medhyal/ecp5-dev-board/README.md

# ecp5-dev-board
ECP5 FPGA DEV BOARD

Lattice LFE5U-12F FPGA  
Built in FTDI FT2232H Programmer

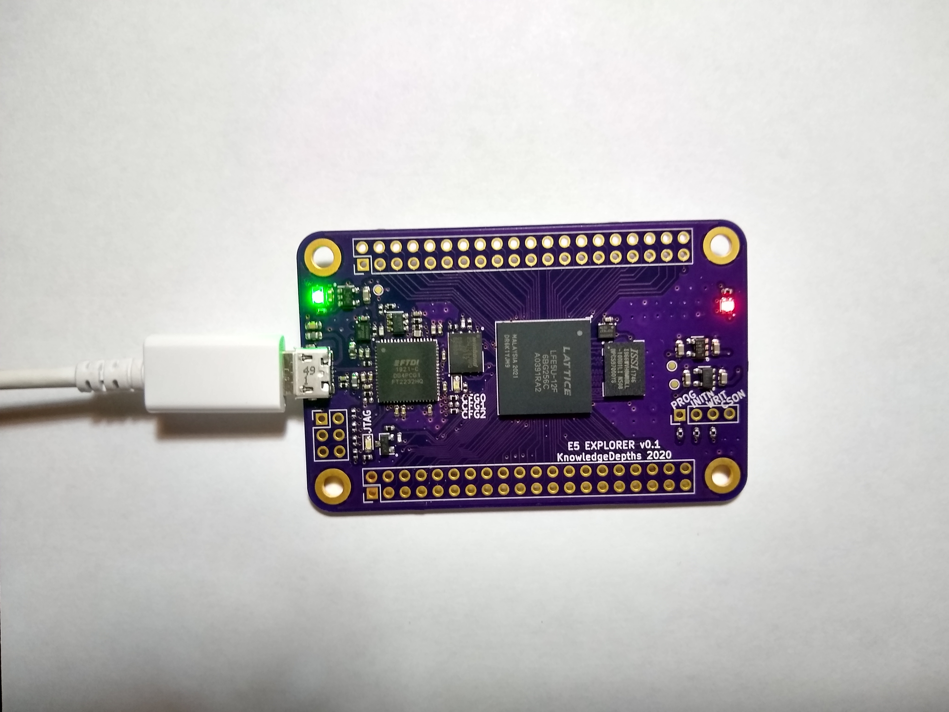
[picture p1: media/ecp5-dev-board.jpg]
ECP5-DEV-BOARD


Errata:  
Q1 - wrong footprint
