medhyal/ecp5-dev-board/v0.1/ecp5-dev-board.kicad_pcb

## KiCad design v0.1/ecp5-dev-board.kicad_pcb (2021-04-18)

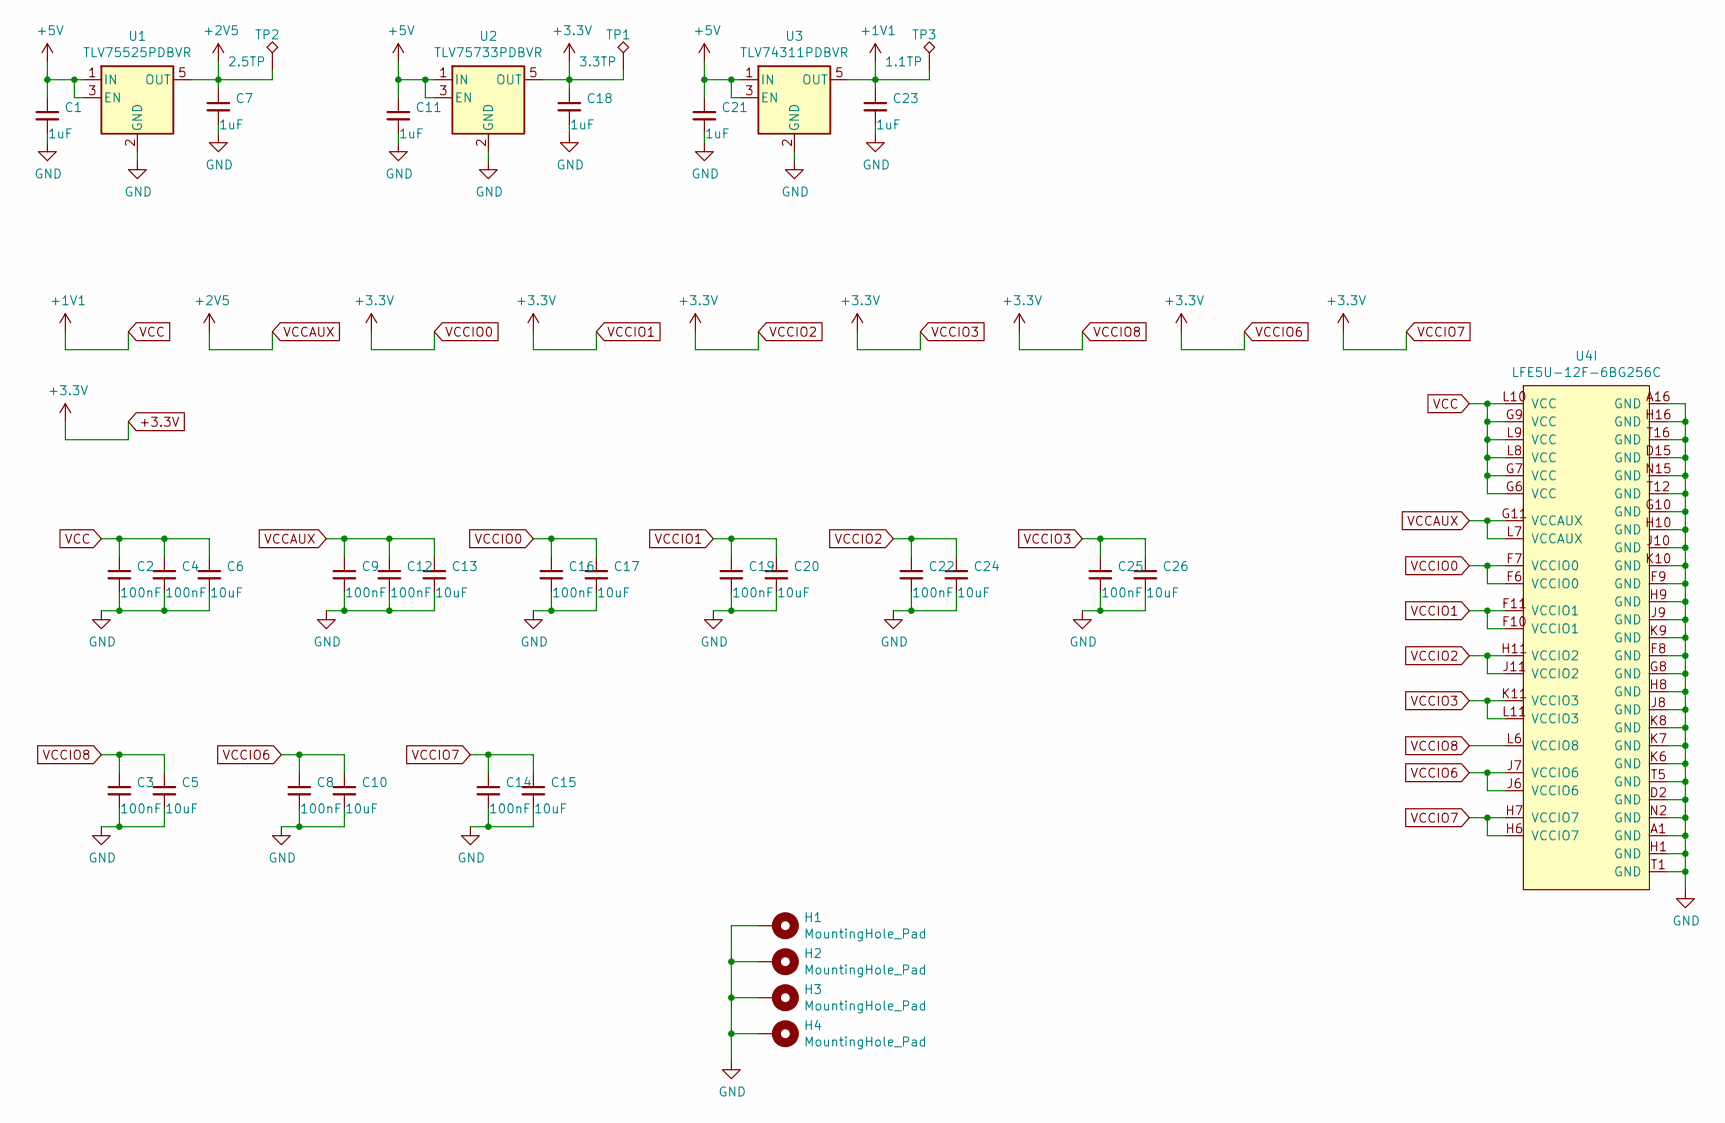
[picture p2: schematic POWER.sch, ECP5 DEV BOARD]

Parts:
C1, C7, C11, C18, C21, C23: 1uF; C_0603_1608Metric
C2, C3, C4, C8, C9, C12, C14, C16, C19, C22, C25: 100nF; C_0402_1005Metric
C5, C6, C10, C13, C15, C17, C20, C24, C26: 10uF; C_0402_1005Metric
H1, H2, H3, H4: MountingHole_Pad; MountingHole_3.2mm_M3_ISO14580_Pad
TP1: 3.3TP; TestPoint_Pad_D1.0mm
TP2: 2.5TP; TestPoint_Pad_D1.0mm
TP3: 1.1TP; TestPoint_Pad_D1.0mm
U1: TLV75525PDBVR; SOT-23-5
U2: TLV75733PDBVR; SOT-23-5
U3: TLV74311PDBVR; SOT-23-5
U4: LFE5U-12F-6BG256C; BGA-256_14.0x14.0mm_Layout16x16_P0.8mm_Ball0.45mm_Pad0.32mm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

Connections:
+3.3V: C3.1, C5.1, C8.1, C10.1, C14.1, C15.1, C16.1, C17.1, C18.1, C19.1, C20.1, C22.1, C24.1, C25.1, C26.1, TP1.1, U2.5 (OUT), U4.F6 (VCCIO0), U4.F7 (VCCIO0), U4.F10 (VCCIO1), U4.F11 (VCCIO1), U4.H6 (VCCIO7), U4.H7 (VCCIO7), U4.H11 (VCCIO2), U4.J6 (VCCIO6), U4.J7 (VCCIO6), U4.J11 (VCCIO2), U4.K11 (VCCIO3), U4.L6 (VCCIO8), U4.L11 (VCCIO3); also elsewhere on the board
+5V: C1.1, C11.1, C21.1, U1.1 (IN), U1.3 (EN), U2.1 (IN), U2.3 (EN), U3.1 (IN), U3.3 (EN); also elsewhere on the board
VCC: C2.1, C4.1, C6.1, C23.1, TP3.1, U3.5 (OUT), U4.G6 (VCC), U4.G7 (VCC), U4.G9 (VCC), U4.L8 (VCC), U4.L9 (VCC), U4.L10 (VCC)
VCCAUX: C7.1, C9.1, C12.1, C13.1, TP2.1, U1.5 (OUT), U4.G11 (VCCAUX), U4.L7 (VCCAUX)

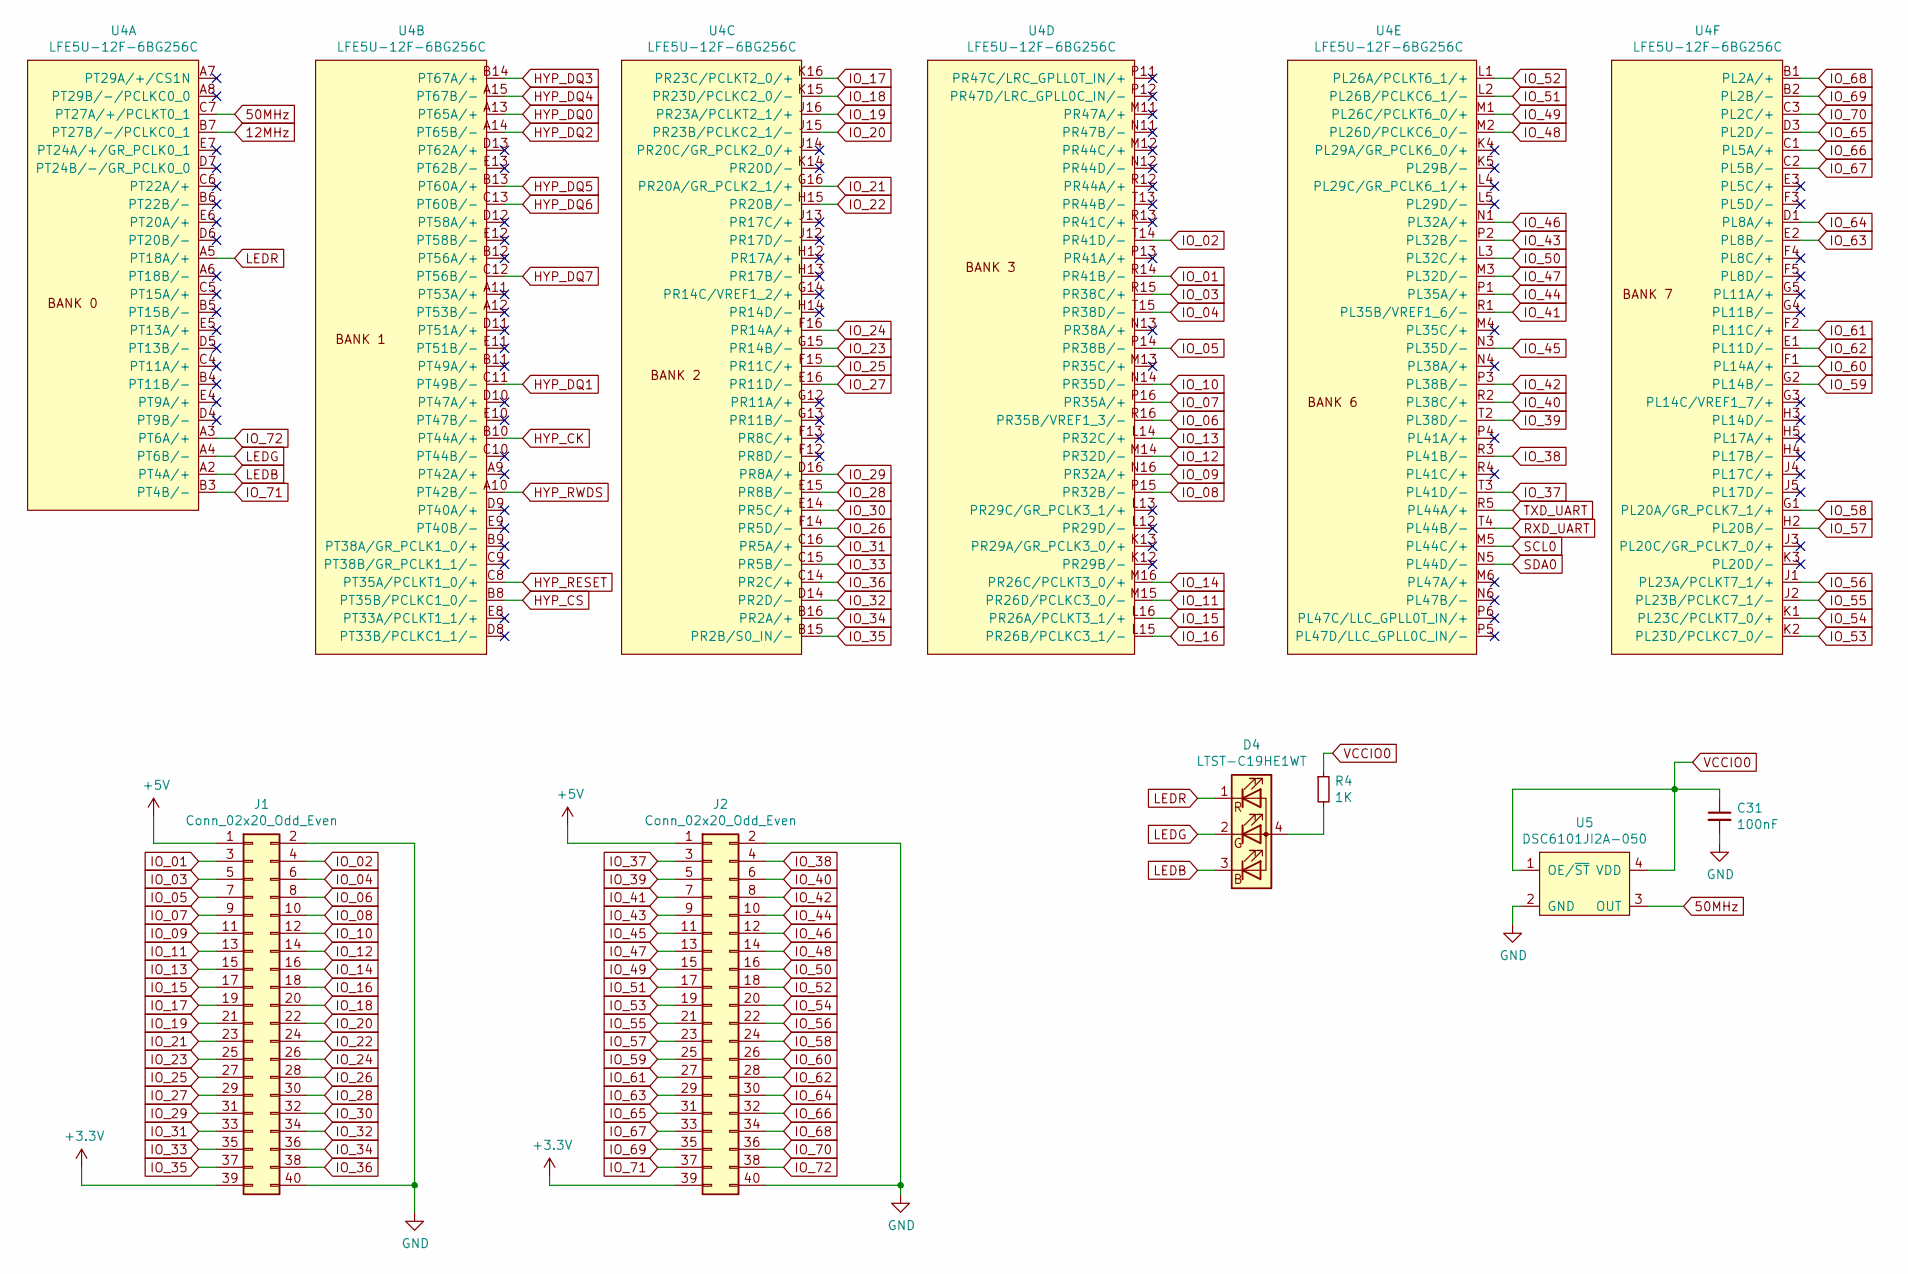
[picture p3: schematic FPGA.sch, ECP5 DEV BOARD]

Parts:
C31: 100nF; C_0402_1005Metric
D4: ‎LTST-C19HE1WT‎; LED_LiteOn_LTST-C19HE1WT
J1, J2: Conn_02x20_Odd_Even; PinHeader_2x20_P2.54mm_Vertical
R4: 1K; R_0402_1005Metric
U4: LFE5U-12F-6BG256C; BGA-256_14.0x14.0mm_Layout16x16_P0.8mm_Ball0.45mm_Pad0.32mm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
U5: DSC6101JI2A-050; DSC6101JI2A-012

Connections:
12MHz: U4.B7 (PT27B/-/PCLKC0_1); also elsewhere on the board
50MHz: U4.C7 (PT27A/+/PCLKT0_1), U5.3 (OUT)
+3.3V: C31.1, J1.39, J2.39, R4.1, U5.1 (OE/~ST), U5.4 (VDD); also elsewhere on the board
+5V: J1.1, J2.1; also elsewhere on the board
HYP_CK: U4.B10 (PT44A/+); also elsewhere on the board
HYP_CS: U4.B8 (PT35B/PCLKC1_0/-); also elsewhere on the board
HYP_DQ0: U4.A13 (PT65A/+); also elsewhere on the board
HYP_DQ1: U4.C11 (PT49B/-); also elsewhere on the board
HYP_DQ2: U4.A14 (PT65B/-); also elsewhere on the board
HYP_DQ3: U4.B14 (PT67A/+); also elsewhere on the board
HYP_DQ4: U4.A15 (PT67B/-); also elsewhere on the board
HYP_DQ5: U4.B13 (PT60A/+); also elsewhere on the board
HYP_DQ6: U4.C13 (PT60B/-); also elsewhere on the board
HYP_DQ7: U4.C12 (PT56B/-); also elsewhere on the board
HYP_RESET: U4.C8 (PT35A/PCLKT1_0/+); also elsewhere on the board
HYP_RWDS: U4.A10 (PT42B/-); also elsewhere on the board
IO_01: J1.3, U4.R14 (PR41B/-)
IO_02: J1.4, U4.T14 (PR41D/-)
IO_03: J1.5, U4.R15 (PR38C/+)
IO_04: J1.6, U4.T15 (PR38D/-)
IO_05: J1.7, U4.P14 (PR38B/-)
IO_06: J1.8, U4.R16 (PR35B/VREF1_3/-)
IO_07: J1.9, U4.P16 (PR35A/+)
IO_08: J1.10, U4.P15 (PR32B/-)
IO_09: J1.11, U4.N16 (PR32A/+)
IO_10: J1.12, U4.N14 (PR35D/-)
IO_11: J1.13, U4.M15 (PR26D/PCLKC3_0/-)
IO_12: J1.14, U4.M14 (PR32D/-)
IO_13: J1.15, U4.L14 (PR32C/+)
IO_14: J1.16, U4.M16 (PR26C/PCLKT3_0/+)
IO_15: J1.17, U4.L16 (PR26A/PCLKT3_1/+)
IO_16: J1.18, U4.L15 (PR26B/PCLKC3_1/-)
IO_17: J1.19, U4.K16 (PR23C/PCLKT2_0/+)
IO_18: J1.20, U4.K15 (PR23D/PCLKC2_0/-)
IO_19: J1.21, U4.J16 (PR23A/PCLKT2_1/+)
IO_20: J1.22, U4.J15 (PR23B/PCLKC2_1/-)
IO_21: J1.23, U4.G16 (PR20A/GR_PCLK2_1/+)
IO_22: J1.24, U4.H15 (PR20B/-)
IO_23: J1.25, U4.G15 (PR14B/-)
IO_24: J1.26, U4.F16 (PR14A/+)
IO_25: J1.27, U4.F15 (PR11C/+)
IO_26: J1.28, U4.F14 (PR5D/-)
IO_27: J1.29, U4.E16 (PR11D/-)
IO_28: J1.30, U4.E15 (PR8B/-)
IO_29: J1.31, U4.D16 (PR8A/+)
IO_30: J1.32, U4.E14 (PR5C/+)
IO_31: J1.33, U4.C16 (PR5A/+)
IO_32: J1.34, U4.D14 (PR2D/-)
IO_33: J1.35, U4.C15 (PR5B/-)
IO_34: J1.36, U4.B16 (PR2A/+)
IO_35: J1.37, U4.B15 (PR2B/S0_IN/-)
IO_36: J1.38, U4.C14 (PR2C/+)
IO_37: J2.3, U4.T3 (PL41D/-)
IO_38: J2.4, U4.R3 (PL41B/-)
IO_39: J2.5, U4.T2 (PL38D/-)
IO_40: J2.6, U4.R2 (PL38C/+)
IO_41: J2.7, U4.R1 (PL35B/VREF1_6/-)
IO_42: J2.8, U4.P3 (PL38B/-)
IO_43: J2.9, U4.P2 (PL32B/-)
IO_44: J2.10, U4.P1 (PL35A/+)
IO_45: J2.11, U4.N3 (PL35D/-)
IO_46: J2.12, U4.N1 (PL32A/+)
IO_47: J2.13, U4.M3 (PL32D/-)
IO_48: J2.14, U4.M2 (PL26D/PCLKC6_0/-)
IO_49: J2.15, U4.M1 (PL26C/PCLKT6_0/+)
IO_50: J2.16, U4.L3 (PL32C/+)
IO_51: J2.17, U4.L2 (PL26B/PCLKC6_1/-)
IO_52: J2.18, U4.L1 (PL26A/PCLKT6_1/+)
IO_53: J2.19, U4.K2 (PL23D/PCLKC7_0/-)
IO_54: J2.20, U4.K1 (PL23C/PCLKT7_0/+)
IO_55: J2.21, U4.J2 (PL23B/PCLKC7_1/-)
IO_56: J2.22, U4.J1 (PL23A/PCLKT7_1/+)
IO_57: J2.23, U4.H2 (PL20B/-)
IO_58: J2.24, U4.G1 (PL20A/GR_PCLK7_1/+)
IO_59: J2.25, U4.G2 (PL14B/-)
IO_60: J2.26, U4.F1 (PL14A/+)
IO_61: J2.27, U4.F2 (PL11C/+)
IO_62: J2.28, U4.E1 (PL11D/-)
IO_63: J2.29, U4.E2 (PL8B/-)
IO_64: J2.30, U4.D1 (PL8A/+)
IO_65: J2.31, U4.D3 (PL2D/-)
IO_66: J2.32, U4.C1 (PL5A/+)
IO_67: J2.33, U4.C2 (PL5B/-)
IO_68: J2.34, U4.B1 (PL2A/+)
IO_69: J2.35, U4.B2 (PL2B/-)
IO_70: J2.36, U4.C3 (PL2C/+)
IO_71: J2.37, U4.B3 (PT4B/-)
IO_72: J2.38, U4.A3 (PT6A/+)
LEDB: D4.3 (BK), U4.A2 (PT4A/+)
LEDG: D4.2 (GK), U4.A4 (PT6B/-)
LEDR: D4.1 (RK), U4.A5 (PT18A/+)
unnamed: D4.4 (A), R4.2
RXD_UART: U4.N5 (PL44D/-), U4.T4 (PL44B/-); also elsewhere on the board
SCL0: U4.M5 (PL44C/+), U4.R5 (PL44A/+); also elsewhere on the board

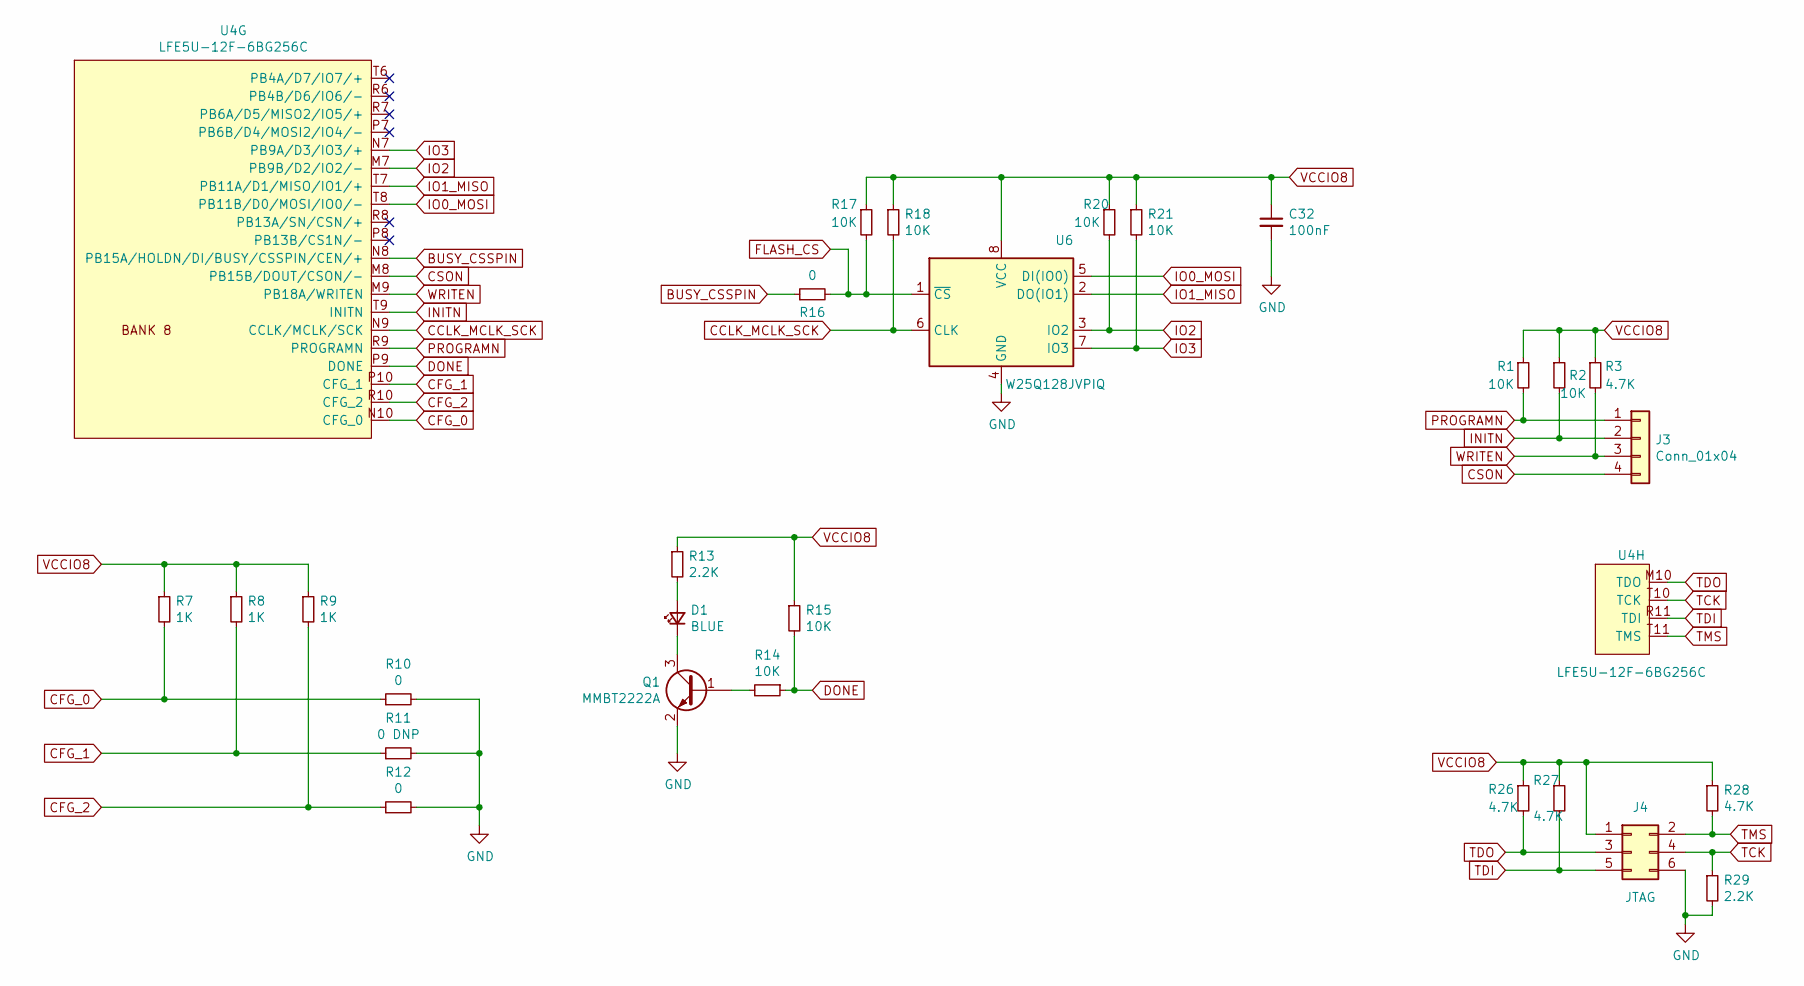
[picture p4: schematic CONFIG.sch, ECP5 DEV BOARD]

Parts:
C32: 100nF; C_0402_1005Metric
D1: BLUE; LED_0603_1608Metric
J3: Conn_01x04; PinHeader_1x04_P2.54mm_Vertical
J4: JTAG; PinHeader_2x03_P2.54mm_Vertical
Q1: MMBT2222A; SOT-23
R1, R2, R14, R15, R17, R18, R20, R21: 10K; R_0402_1005Metric
R3, R26, R27, R28: 4.7K; R_0402_1005Metric
R7, R8, R9: 1K; R_0402_1005Metric
R10, R12, R16: 0; R_0402_1005Metric
R11: 0 DNP; R_0402_1005Metric
R13, R29: 2.2K; R_0402_1005Metric
U4: LFE5U-12F-6BG256C; BGA-256_14.0x14.0mm_Layout16x16_P0.8mm_Ball0.45mm_Pad0.32mm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
U6: W25Q128JVPIQ; WSON-8-1EP_6x5mm_P1.27mm_EP3.4x4.3mm

Connections:
+3.3V: C32.1, J4.1, R1.1, R2.1, R3.1, R7.1, R8.1, R9.1, R13.1, R15.1, R17.1, R18.1, R20.1, R21.1, R26.1, R27.1, R28.1, U6.8 (VCC); also elsewhere on the board
BUSY_CSSPIN: R16.1, U4.N8 (PB15A/HOLDN/DI/BUSY/CSSPIN/CEN/+)
CCLK_MCLK_SCK: R18.2, U4.N9 (CCLK/MCLK/SCK), U6.6 (CLK)
CFG_0: R7.2, R10.1, U4.N10 (CFG_0)
CFG_1: R8.2, R11.1, U4.P10 (CFG_1)
CFG_2: R9.2, R12.1, U4.R10 (CFG_2)
CSON: J3.4, U4.M8 (PB15B/DOUT/CSON/-)
DONE: R14.1, R15.2, U4.P9 (DONE)
FLASH_CS: R16.2, R17.2, U6.1 (~CS)
INITN: J3.2, R2.2, U4.T9 (INITN)
IO0_MOSI: U4.T8 (PB11B/D0/MOSI/IO0/-), U6.5 (DI(IO0))
IO1_MISO: U4.T7 (PB11A/D1/MISO/IO1/+), U6.2 (DO(IO1))
IO2: R20.2, U4.M7 (PB9B/D2/IO2/-), U6.3 (IO2)
IO3: R21.2, U4.N7 (PB9A/D3/IO3/+), U6.7 (IO3)
unnamed: D1.1 (K), Q1.3 (C)
unnamed: D1.2 (A), R13.2
PROGRAMN: J3.1, R1.2, U4.R9 (PROGRAMN)
TCK: J4.4, R29.1, U4.T10 (TCK); also elsewhere on the board
TDI: J4.5, R27.2, U4.R11 (TDI); also elsewhere on the board
TDO: J4.3, R26.2, U4.M10 (TDO); also elsewhere on the board
TMS: J4.2, R28.2, U4.T11 (TMS); also elsewhere on the board
WRITEN: J3.3, R3.2, U4.M9 (PB18A/WRITEN)

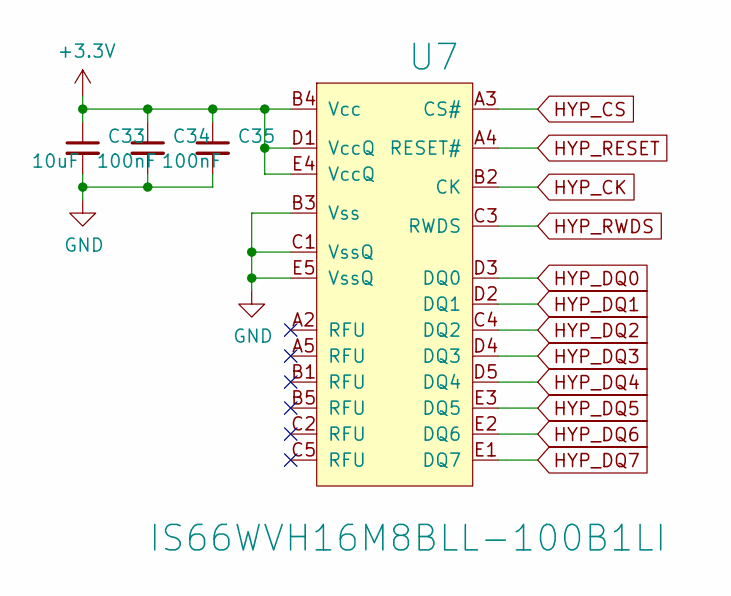
[picture p5: schematic RAM.sch, ECP5 DEV BOARD]

Parts:
C33: 10uF; C_0402_1005Metric
C34, C35: 100nF; C_0402_1005Metric
U7: IS66WVH16M8BLL-100B1LI; 24-TFBGA (6x8)

Connections:
+3.3V: C33.1, C34.1, C35.1, U7.B4 (Vcc), U7.D1 (VccQ), U7.E4 (VccQ); also elsewhere on the board
HYP_CK: U7.B2 (CK); also elsewhere on the board
HYP_CS: U7.A3 (CS#); also elsewhere on the board
HYP_DQ0: U7.D3 (DQ0); also elsewhere on the board
HYP_DQ1: U7.D2 (DQ1); also elsewhere on the board
HYP_DQ2: U7.C4 (DQ2); also elsewhere on the board
HYP_DQ3: U7.D4 (DQ3); also elsewhere on the board
HYP_DQ4: U7.D5 (DQ4); also elsewhere on the board
HYP_DQ5: U7.E3 (DQ5); also elsewhere on the board
HYP_DQ6: U7.E2 (DQ6); also elsewhere on the board
HYP_DQ7: U7.E1 (DQ7); also elsewhere on the board
HYP_RESET: U7.A4 (RESET#); also elsewhere on the board
HYP_RWDS: U7.C3 (RWDS); also elsewhere on the board

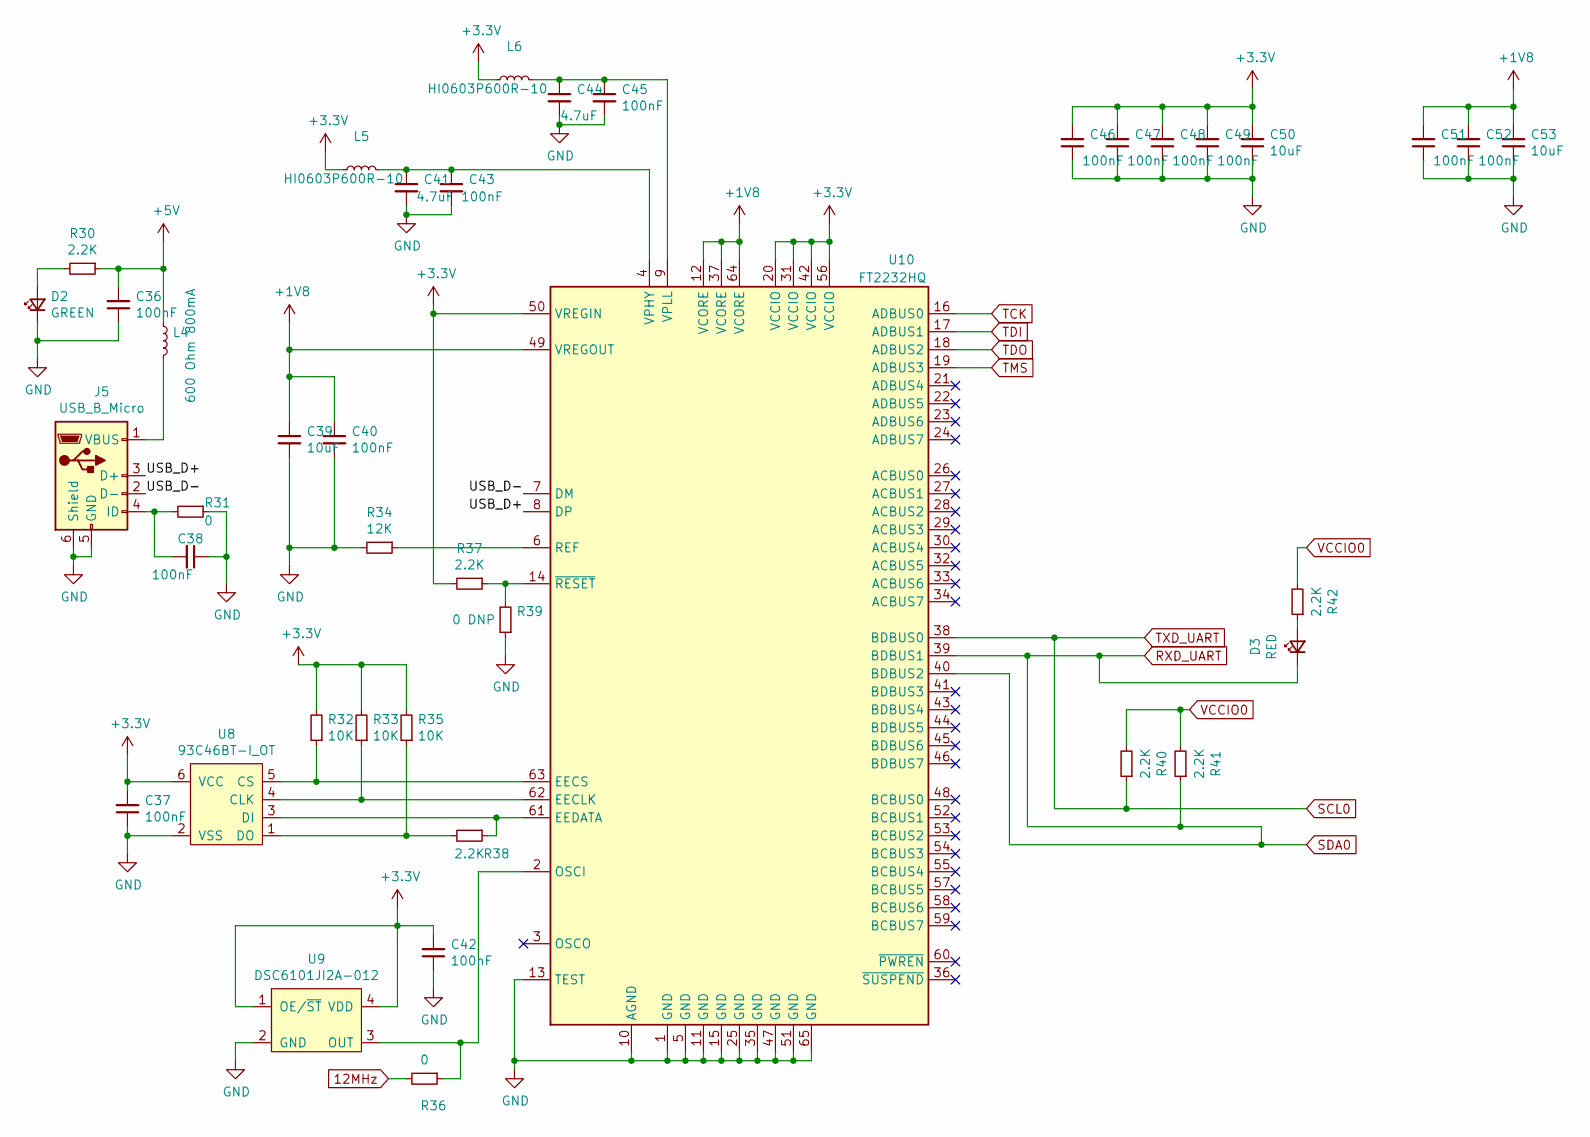
[picture p6: schematic USB_FTDI.sch, ECP5 DEV BOARD]

Parts:
C36: 100nF; C_0603_1608Metric
C37, C38, C40, C42, C43, C45, C46, C47, C48, C49, C51, C52: 100nF; C_0402_1005Metric
C39, C50, C53: 10uF; C_0402_1005Metric
C41, C44: 4.7uF; C_0402_1005Metric
D2: GREEN; LED_0603_1608Metric
D3: RED; LED_0603_1608Metric
J5: USB_B_Micro; USB_Micro-B_Molex_47346-0001
L4: 600 Ohm 800mA; L_0603_1608Metric
L5, L6: HI0603P600R-10; L_0603_1608Metric
R30, R37, R38, R40, R41, R42: 2.2K; R_0402_1005Metric
R31, R36: 0; R_0402_1005Metric
R32, R33, R35: 10K; R_0402_1005Metric
R34: 12K; R_0402_1005Metric
R39: 0 DNP; R_0402_1005Metric
U8: 93C46BT-I_OT; SOT-23-6
U9: DSC6101JI2A-012
U10: FT2232HQ; QFN-64-1EP_9x9mm_P0.5mm_EP4.35x4.35mm

Connections:
12MHz: R36.2; also elsewhere on the board
+1V8: C39.1, C40.1, C51.2, C52.2, C53.2, U10.12 (VCORE), U10.37 (VCORE), U10.49 (VREGOUT), U10.64 (VCORE)
+3.3V: C37.2, C42.2, C46.2, C47.2, C48.2, C49.2, C50.2, L5.1, L6.1, R32.2, R33.2, R35.2, R37.2, R40.2, R41.2, R42.2, U8.6 (VCC), U9.1 (OE/~ST), U9.4 (VDD), U10.20 (VCCIO), U10.31 (VCCIO), U10.42 (VCCIO), U10.50 (VREGIN), U10.56 (VCCIO); also elsewhere on the board
+5V: C36.2, L4.1, R30.1; also elsewhere on the board
/USB_FTDI/USB_D+: J5.3 (D+), U10.8 (DP)
/USB_FTDI/USB_D-: J5.2 (D-), U10.7 (DM)
unnamed: C38.2, J5.4 (ID), R31.2
unnamed: C41.1, C43.1, L5.2, U10.4 (VPHY)
unnamed: C44.1, C45.1, L6.2, U10.9 (VPLL)
unnamed: D2.2 (A), R30.2
unnamed: D3.2 (A), R42.1
unnamed: J5.1 (VBUS), L4.2
unnamed: R32.1, U8.5 (CS), U10.63 (EECS)
unnamed: R33.1, U8.4 (CLK), U10.62 (EECLK)
unnamed: R34.1, U10.6 (REF)
unnamed: R35.1, R38.2, U8.1 (DO)
unnamed: R36.1, U9.3 (OUT), U10.2 (OSCI)
unnamed: R37.1, R39.2, U10.14 (~RESET)
unnamed: R38.1, U8.3 (DI), U10.61 (EEDATA)
RXD_UART: D3.1 (K), R41.1, U10.39 (BDBUS1), U10.40 (BDBUS2); also elsewhere on the board
SCL0: R40.1, U10.38 (BDBUS0); also elsewhere on the board
TCK: U10.16 (ADBUS0); also elsewhere on the board
TDI: U10.17 (ADBUS1); also elsewhere on the board
TDO: U10.18 (ADBUS2); also elsewhere on the board
TMS: U10.19 (ADBUS3); also elsewhere on the board

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
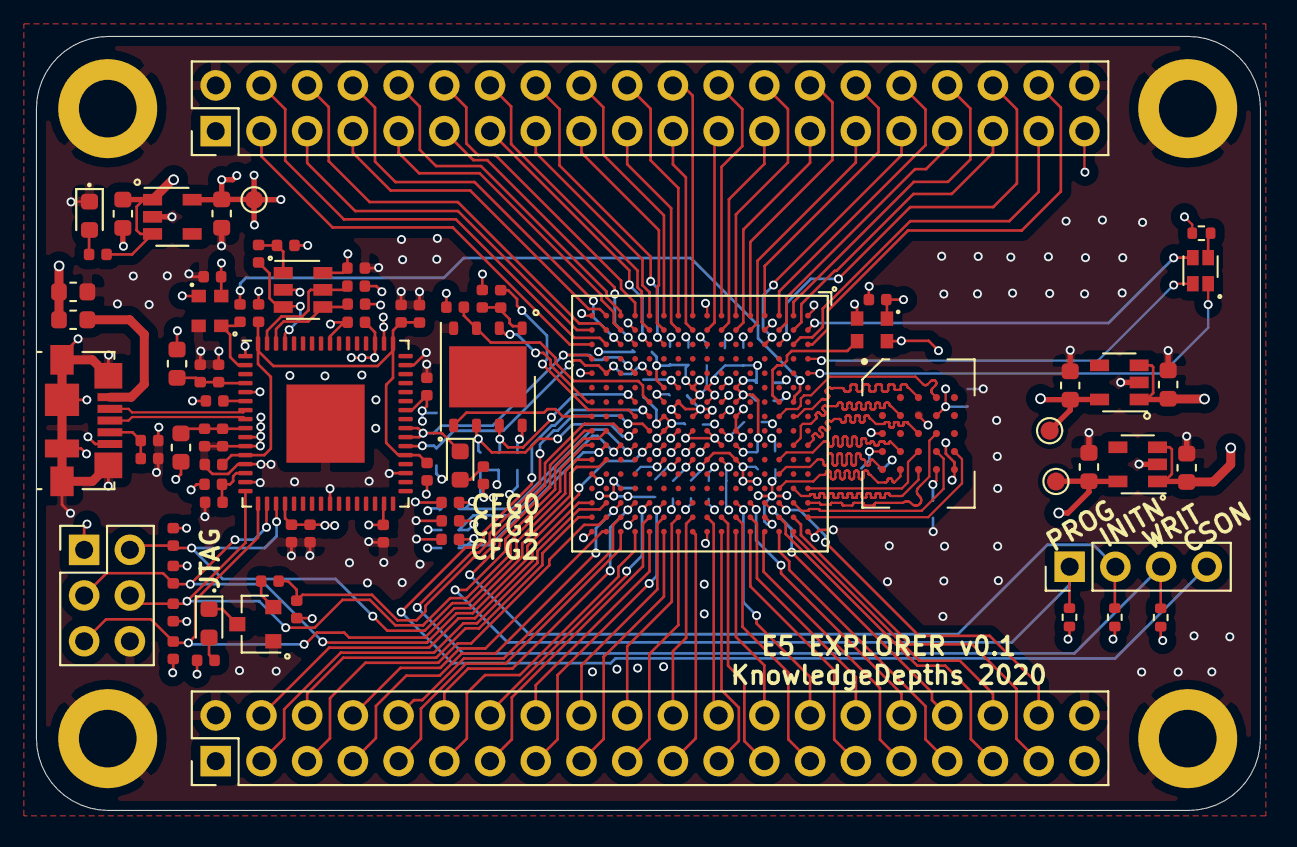
[picture p7: board ecp5-dev-board.kicad_pcb from above]

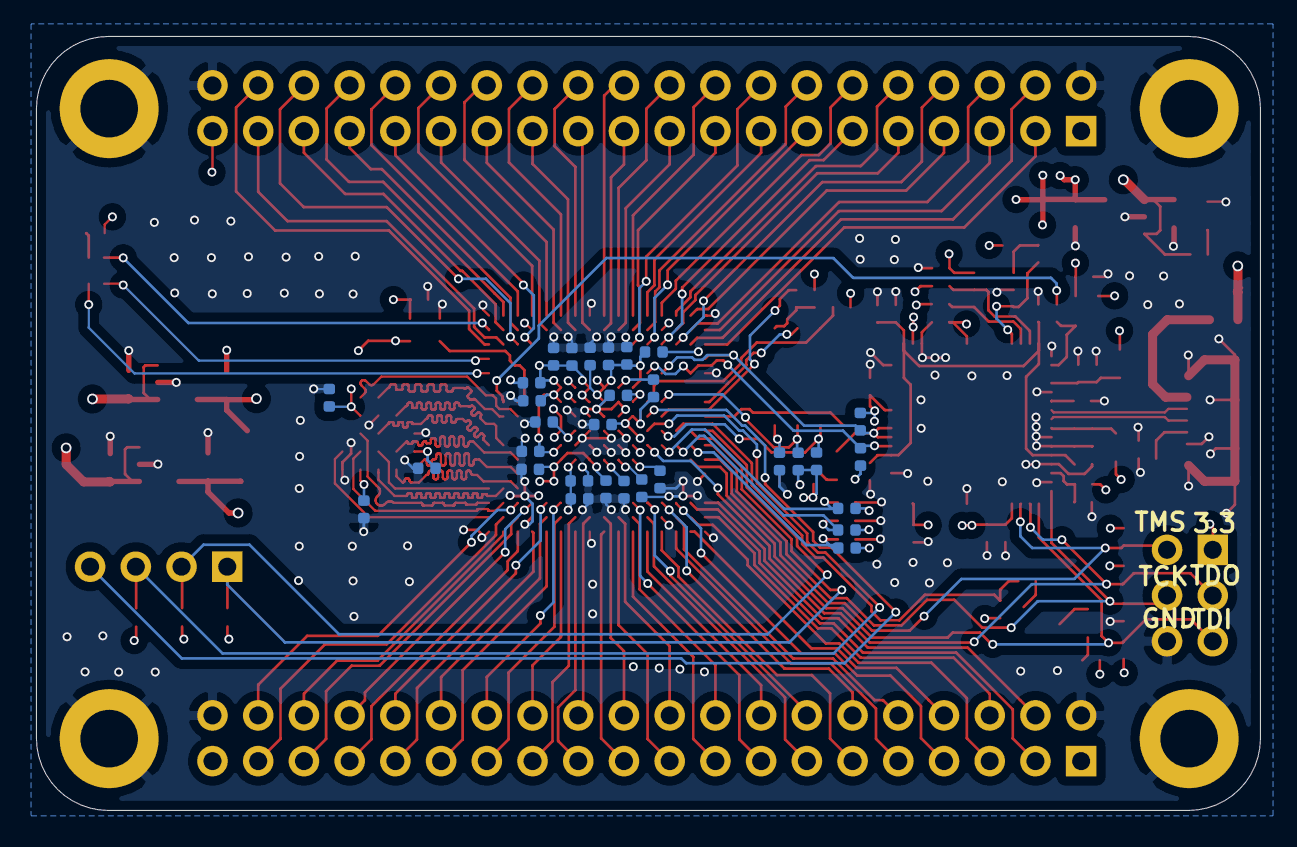
[picture p8: board ecp5-dev-board.kicad_pcb from below]

Board: 4 copper layers, 68.0 x 43.0 mm, 114 parts (31 on the bottom side), 135 nets.
